Xk-fly/optical-flow-rangefinder-module/(list of files, drawings)

Other design files:
光流模块原理图和PCB/光流原理图与PCB整体.epro
