Xk-fly/optical-flow-rangefinder-module/Core/Src/main.c

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
/* Includes ------------------------------------------------------------------*/
#include "main.h"

/* USER CODE BEGIN Includes */
#include "PMW3901MB/pmw_3901.h"
#include "VL53L1X/vl53l1x.h"
#include "VL53L1X/vl53_ground_bootstrap.h"
#include "Adapter/massage_adapter.h"

/* USER CODE END Includes */

/* USER CODE BEGIN PD */
#define PMW_READ_DELAY_MS               1U
#define PMW_INIT_RETRY_INTERVAL_MS      1000U
#define PMW_SCALE_PER_MILLE             3000U
#define FLOW_PERIOD_MS                  20U
#define DISTANCE_PERIOD_MS              100U
#define HEARTBEAT_PERIOD_MS             1000U
#define PMW3901_ENABLE_PERIODIC_DIAGNOSTICS 0U
#if PMW3901_ENABLE_PERIODIC_DIAGNOSTICS
#define PMW_DIAG_PERIOD_MS              1000U
#endif

#if PMW3901_ACQUISITION_MODE == PMW3901_ACQ_DIRECT
#define PMW_MODE_STATUS_TEXT             "PMW mode direct"
#else
#define PMW_MODE_STATUS_TEXT             "PMW mode burst"
#endif

/* USER CODE END PD */

I2C_HandleTypeDef hi2c2;

SPI_HandleTypeDef hspi1;

TIM_HandleTypeDef htim14;

UART_HandleTypeDef huart2;

void SystemClock_Config(void);
static void MX_GPIO_Init(void);
static void MX_SPI1_Init(void);
static void MX_USART2_UART_Init(void);
static void MX_TIM14_Init(void);
static void MX_I2C2_Init(void);
/* USER CODE BEGIN PFP */
static void PMW_SendInitFailed(uint8_t err);
#if PMW3901_ENABLE_PERIODIC_DIAGNOSTICS
static void PMW_SendRawDiagnostics(void);
static void PMW_SendDirectDiagnostics(const PMW3901_Diagnostics *diagnostics);
static void PMW_SendDirectStatistics(const PMW3901_Diagnostics *diagnostics);
static void PMW_SendBurstStatistics(const PMW3901_Diagnostics *diagnostics);
#endif
static void PMW_SendConfigDiagnostics(void);
static uint8_t PMW_AppendChar(char *message, uint8_t index, char value);
static uint8_t PMW_AppendText(char *message, uint8_t index, const char *text);
static uint8_t PMW_AppendHex8(char *message, uint8_t index, uint8_t value);
#if PMW3901_ENABLE_PERIODIC_DIAGNOSTICS
static uint8_t PMW_AppendHex16(char *message, uint8_t index, uint16_t value);
#endif
static uint8_t PMW_AppendUnsigned(char *message, uint8_t index, uint32_t value);
#if PMW3901_ENABLE_PERIODIC_DIAGNOSTICS
static uint8_t PMW_AppendSigned(char *message, uint8_t index, int16_t value);
#endif

/* USER CODE END PFP */

/* USER CODE BEGIN 0 */
static void PMW_SendInitFailed(uint8_t err)
{
	char msg[] = "PMW init failed err=000";
	uint8_t index = 20U;

	if (err >= 100U) {
		msg[index++] = (char)('0' + (err / 100U));
		msg[index++] = (char)('0' + ((err / 10U) % 10U));
		msg[index++] = (char)('0' + (err % 10U));
		msg[index] = '\0';
	} else if (err >= 10U) {
		msg[index++] = (char)('0' + (err / 10U));
		msg[index++] = (char)('0' + (err % 10U));
		msg[index] = '\0';
	} else {
		msg[index++] = (char)('0' + err);
		msg[index] = '\0';
	}

	send_status_text(&huart2, MAV_SEVERITY_WARNING, msg);
}

static uint8_t PMW_AppendChar(char *message, uint8_t index, char value)
{
	if (index < 49U) {
		message[index++] = value;
	}
	message[index] = '\0';
	return index;
}

static uint8_t PMW_AppendText(char *message, uint8_t index, const char *text)
{
	while ((*text != '\0') && (index < 49U)) {
		message[index++] = *text++;
	}
	message[index] = '\0';
	return index;
}

static uint8_t PMW_AppendHex8(char *message, uint8_t index, uint8_t value)
{
	static const char hex[] = "0123456789ABCDEF";
	index = PMW_AppendChar(message, index, hex[(value >> 4) & 0x0FU]);
	return PMW_AppendChar(message, index, hex[value & 0x0FU]);
}

#if PMW3901_ENABLE_PERIODIC_DIAGNOSTICS
static uint8_t PMW_AppendHex16(char *message, uint8_t index, uint16_t value)
{
	index = PMW_AppendHex8(message, index, (uint8_t)(value >> 8));
	return PMW_AppendHex8(message, index, (uint8_t)value);
}
#endif

static uint8_t PMW_AppendUnsigned(char *message, uint8_t index, uint32_t value)
{
	char digits[3];
	uint8_t count = 0U;

	if (value > 999U) {
		value = 999U;
	}
	do {
		digits[count++] = (char)('0' + (value % 10U));
		value /= 10U;
	} while ((value != 0U) && (count < sizeof(digits)));

	while (count > 0U) {
		index = PMW_AppendChar(message, index, digits[--count]);
	}
	return index;
}

#if PMW3901_ENABLE_PERIODIC_DIAGNOSTICS
static uint8_t PMW_AppendSigned(char *message, uint8_t index, int16_t value)
{
	int32_t signed_value = value;
	uint32_t magnitude;
	char digits[5];
	uint8_t count = 0U;

	if (signed_value < 0) {
		index = PMW_AppendChar(message, index, '-');
		magnitude = (uint32_t)(-signed_value);
	} else {
		magnitude = (uint32_t)signed_value;
	}

	do {
		digits[count++] = (char)('0' + (magnitude % 10U));
		magnitude /= 10U;
	} while ((magnitude != 0U) && (count < sizeof(digits)));

	while (count > 0U) {
		index = PMW_AppendChar(message, index, digits[--count]);
	}
	return index;
}
#endif

#if PMW3901_ENABLE_PERIODIC_DIAGNOSTICS
static void PMW_SendRawDiagnostics(void)
{
	PMW3901_Diagnostics diagnostics;
	char message[50] = {0};
	uint8_t index = 0U;

	PMW3901_GetDiagnostics(&diagnostics);
	index = PMW_AppendText(message, index, "P S");
	index = PMW_AppendUnsigned(message, index, diagnostics.last_status);
	index = PMW_AppendText(message, index, " M");
	index = PMW_AppendHex8(message, index, diagnostics.last_raw.motion);
	index = PMW_AppendText(message, index, " O");
	index = PMW_AppendHex8(message, index, diagnostics.last_raw.observation);
	index = PMW_AppendText(message, index, " X");
	index = PMW_AppendSigned(message, index, diagnostics.last_raw.delta_x);
	index = PMW_AppendText(message, index, " Y");
	index = PMW_AppendSigned(message, index, diagnostics.last_raw.delta_y);
	index = PMW_AppendText(message, index, " Q");
	index = PMW_AppendUnsigned(message, index, diagnostics.last_raw.squal);
	index = PMW_AppendText(message, index, " H");
	index = PMW_AppendHex16(message, index, diagnostics.last_raw.shutter);
	index = PMW_AppendText(message, index, " E");
	index = PMW_AppendUnsigned(message, index, diagnostics.spi_error_count);
	index = PMW_AppendText(message, index, " R");
	(void)PMW_AppendUnsigned(message, index, diagnostics.reject_count);
	send_status_text(&huart2, MAV_SEVERITY_DEBUG, message);
	PMW_SendDirectDiagnostics(&diagnostics);
	PMW_SendDirectStatistics(&diagnostics);
	PMW_SendBurstStatistics(&diagnostics);
}

static void PMW_SendDirectDiagnostics(const PMW3901_Diagnostics *diagnostics)
{
	char message[50] = {0};
	uint8_t index = 0U;

	index = PMW_AppendText(message, index, "D S");
	index = PMW_AppendUnsigned(message, index, diagnostics->direct_status);
	index = PMW_AppendText(message, index, " M");
	index = PMW_AppendHex8(message, index, diagnostics->last_direct.motion);
	index = PMW_AppendText(message, index, " O");
	index = PMW_AppendHex8(message, index, diagnostics->last_direct.observation);
	index = PMW_AppendText(message, index, " X");
	index = PMW_AppendSigned(message, index, diagnostics->last_direct.delta_x);
	index = PMW_AppendText(message, index, " Y");
	index = PMW_AppendSigned(message, index, diagnostics->last_direct.delta_y);
	index = PMW_AppendText(message, index, " Q");
	index = PMW_AppendUnsigned(message, index, diagnostics->last_direct.squal);
	index = PMW_AppendText(message, index, " H");
	index = PMW_AppendHex16(message, index, diagnostics->last_direct.shutter);
	index = PMW_AppendText(message, index, " E");
	(void)PMW_AppendUnsigned(message, index, diagnostics->spi_error_count);
	send_status_text(&huart2, MAV_SEVERITY_DEBUG, message);
}

static void PMW_SendDirectStatistics(const PMW3901_Diagnostics *diagnostics)
{
	char message[50] = {0};
	uint8_t index = 0U;

	index = PMW_AppendText(message, index, "T C");
	index = PMW_AppendUnsigned(message, index, diagnostics->direct_sample_count);
	index = PMW_AppendText(message, index, " V");
	index = PMW_AppendUnsigned(message, index, diagnostics->direct_motion_count);
	index = PMW_AppendText(message, index, " Q");
	(void)PMW_AppendUnsigned(message, index, diagnostics->direct_squal_nonzero_count);
	send_status_text(&huart2, MAV_SEVERITY_DEBUG, message);
}

static void PMW_SendBurstStatistics(const PMW3901_Diagnostics *diagnostics)
{
	char message[50] = {0};
	uint8_t index = 0U;

	index = PMW_AppendText(message, index, "R U");
	index = PMW_AppendUnsigned(message, index, diagnostics->last_raw.raw_sum);
	index = PMW_AppendText(message, index, " A");
	index = PMW_AppendUnsigned(message, index, diagnostics->last_raw.raw_max);
	index = PMW_AppendText(message, index, " I");
	index = PMW_AppendUnsigned(message, index, diagnostics->last_raw.raw_min);
	index = PMW_AppendText(message, index, " C");
	index = PMW_AppendUnsigned(message, index, diagnostics->sample_count);
	index = PMW_AppendText(message, index, " V");
	index = PMW_AppendUnsigned(message, index, diagnostics->motion_count);
	index = PMW_AppendText(message, index, " Q");
	(void)PMW_AppendUnsigned(message, index, diagnostics->squal_nonzero_count);
	send_status_text(&huart2, MAV_SEVERITY_DEBUG, message);
}
#endif

static void PMW_SendConfigDiagnostics(void)
{
	PMW3901_Diagnostics diagnostics;
	char message[50] = {0};
	uint8_t index = 0U;

	PMW3901_GetDiagnostics(&diagnostics);
	index = PMW_AppendText(message, index, "C S");
	index = PMW_AppendUnsigned(message, index, diagnostics.config_status);
	index = PMW_AppendText(message, index, " D");
	index = PMW_AppendHex8(message, index, diagnostics.config_bank0_4d);
	index = PMW_AppendText(message, index, " A");
	index = PMW_AppendHex8(message, index, diagnostics.config_bank14_65);
	index = PMW_AppendText(message, index, " F");
	index = PMW_AppendHex8(message, index, diagnostics.config_bank15_48);
	index = PMW_AppendText(message, index, " N");
	(void)PMW_AppendUnsigned(message, index, diagnostics.config_mismatch_count);
	send_status_text(&huart2, MAV_SEVERITY_INFO, message);
}

/* USER CODE END 0 */

/**
  * @brief  The application entry point.
  * @retval int
  */
int main(void)
{

  /* MCU Configuration--------------------------------------------------------*/

  /* Reset of all peripherals, Initializes the Flash interface and the Systick. */
  HAL_Init();

  /* Configure the system clock */
  SystemClock_Config();

  /* Initialize all configured peripherals */
  MX_GPIO_Init();
  MX_SPI1_Init();
  MX_USART2_UART_Init();
	  MX_TIM14_Init();
	  MX_I2C2_Init();
	  /* USER CODE BEGIN 2 */
	  HAL_GPIO_WritePin(GPIOA, GPIO_PIN_4, GPIO_PIN_SET);

	  uint8_t pmw_err = PMW3901_init(hspi1, PMW_READ_DELAY_MS);
	  uint8_t pmw_ok = (pmw_err == 0U);
	  uint32_t pmw_last_retry_ms = HAL_GetTick();

	  if (pmw_ok) {
		  send_status_text(&huart2, MAV_SEVERITY_INFO, "PMW init ok");
		  send_status_text(&huart2, MAV_SEVERITY_INFO, PMW_MODE_STATUS_TEXT);
		  PMW_SendConfigDiagnostics();
	  } else {
		  PMW_SendInitFailed(pmw_err);
	  }
	  uint8_t vl53_ok = vl53_Init();
	  VL53GroundBootstrap range_bootstrap;
	  VL53GroundBootstrap_Reset(&range_bootstrap);
	  VL53RangeMode announced_range_mode = VL53_RANGE_BOOTSTRAP;
	  uint8_t announced_range_mode_valid = 0U;
	  send_status_text(&huart2, vl53_ok ? MAV_SEVERITY_INFO : MAV_SEVERITY_WARNING,
	                   vl53_ok ? "VL53 init ok" : "VL53 init failed");
	  send_heart_beat(&huart2);
  /* USER CODE END 2 */
  /* Infinite loop */
  /* USER CODE BEGIN WHILE */
  uint32_t scheduler_start_ms = HAL_GetTick();
  uint32_t last_flow_ms = scheduler_start_ms;
  uint32_t last_distance_ms = scheduler_start_ms;
  uint32_t last_heartbeat_ms = scheduler_start_ms;
#if PMW3901_ENABLE_PERIODIC_DIAGNOSTICS
  uint32_t last_diag_ms = scheduler_start_ms;
#endif
  uint16_t distance = 0U;
  uint8_t has_distance = 0U;
  uint32_t last_distance_update_ms = 0U;

  while (1) {
	  uint32_t now = HAL_GetTick();

	  if ((!pmw_ok) && (now - pmw_last_retry_ms >= PMW_INIT_RETRY_INTERVAL_MS)) {
		  pmw_last_retry_ms = now;
		  pmw_err = PMW3901_init(hspi1, PMW_READ_DELAY_MS);
		  pmw_ok = (pmw_err == 0U);
		  if (pmw_ok) {
			  send_status_text(&huart2, MAV_SEVERITY_INFO, "PMW init ok");
			  send_status_text(&huart2, MAV_SEVERITY_INFO, PMW_MODE_STATUS_TEXT);
			  PMW_SendConfigDiagnostics();
		  } else {
			  PMW_SendInitFailed(pmw_err);
		  }
	  }

#if PMW3901_ENABLE_PERIODIC_DIAGNOSTICS
	  if (now - last_diag_ms >= PMW_DIAG_PERIOD_MS) {
		  last_diag_ms = now;
		  PMW_SendRawDiagnostics();
	  }
#endif

	  if (now - last_flow_ms >= FLOW_PERIOD_MS) {
		  int x = 0;
		  int y = 0;
		  uint8_t quality = 0U;

		  last_flow_ms = now;
		  if (pmw_ok) {
			  pollingMotion(&x, &y, &quality, PMW_SCALE_PER_MILLE);
		  }
		  uint8_t distance_fresh = (has_distance != 0U) &&
		                           ((now - last_distance_update_ms) <= VL53_DISTANCE_FRESH_TIMEOUT_MS);
		  send_optical_flow(&huart2, x, y, quality, distance, distance_fresh);
	  }

	  if (now - last_distance_ms >= DISTANCE_PERIOD_MS) {
		  uint16_t new_distance = 0U;
		  uint16_t published_distance = 0U;
		  uint8_t using_bootstrap = 0U;
		  last_distance_ms = now;

		  if (vl53_ok) {
			  VL53ReadResult read_result = vl53_GetDistance(&new_distance);

			  if (VL53GroundBootstrap_Update(&range_bootstrap,
			                                 read_result,
			                                 new_distance,
			                                 &published_distance,
			                                 &using_bootstrap) != 0U) {
				  VL53RangeMode published_mode =
				      (using_bootstrap != 0U) ? VL53_RANGE_BOOTSTRAP : VL53_RANGE_REAL_FLIGHT;

				  distance = published_distance;
				  has_distance = 1U;
				  last_distance_update_ms = HAL_GetTick();
				  send_distance_sensor(&huart2, distance);

				  if ((announced_range_mode_valid == 0U) ||
				      (published_mode != announced_range_mode)) {
					  announced_range_mode = published_mode;
					  announced_range_mode_valid = 1U;
					  send_status_text(&huart2,
					                   MAV_SEVERITY_INFO,
					                   (published_mode == VL53_RANGE_BOOTSTRAP) ?
					                       "VL53 ground bootstrap V3 5cm" :
					                       "VL53 real range active");
				  }
			  }
		  }
	  }

	  if (now - last_heartbeat_ms >= HEARTBEAT_PERIOD_MS) {
		  last_heartbeat_ms = now;
		  send_heart_beat(&huart2);
	  }

    /* USER CODE END WHILE */

    /* USER CODE BEGIN 3 */
  }
  /* USER CODE END 3 */
}

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
