Xk-fly/optical-flow-rangefinder-module/STM32G030F6P6TR.ioc

Mcu.UserName=STM32G030F6Px
PA1.Signal=SPI1_SCK
PA13.Signal=SYS_SWDIO
PA14-BOOT0.Signal=SYS_SWCLK
PA2.Signal=USART2_TX
PA3.Signal=USART2_RX
PA4.Signal=GPIO_Output
PA6.Signal=SPI1_MISO
PA7.Signal=SPI1_MOSI
