Xk-fly/optical-flow-rangefinder-module/Core/Src/Adapter/massage_adapter.h

#include "main.h"
#include "mavlink/common/mavlink.h"
//#include "../mavlink/ardupilotmega/ardupilotmega.h"


void send_optical_flow(UART_HandleTypeDef *huart,int16_t flow_x, int16_t flow_y,
                       uint8_t quality, uint16_t distance_mm, uint8_t distance_valid);

void send_heart_beat(UART_HandleTypeDef *huart);

void send_distance_sensor(UART_HandleTypeDef *huart,uint16_t distance);

void send_status_text(UART_HandleTypeDef *huart, uint8_t severity, const char *text);
