Xk-fly/optical-flow-rangefinder-module/(commit log)

2026-09-04 chore: stage source import payload
2026-09-04 feat: import optical flow rangefinder module source
    [光流原理图与PCB整体.epro]
2026-09-18 fix: add lightweight median filter to VL53 distance
    [vl53l1x.c]
2026-09-18 fix: keep recent VL53 distance fresh for optical flow
    [main.c]
2026-09-18 fix: harden VL53 median filtering and freshness
    [main.c, test_vl53_median_filter.c, verify_production_firmware.py, vl53_median_filter.c, vl53_median_filter.h, vl53l1x.c, vl53l1x.h]
2026-09-23 feat: add VL53 ground bootstrap state machine
2026-09-23 test: cover VL53 ground bootstrap safety
2026-09-23 test: add VL53 ground bootstrap host runner
2026-09-23 feat: publish safe 5cm ground bootstrap range
2026-09-23 test: enforce ground bootstrap production contract
2026-09-23 docs: document safe VL53 ground bootstrap
2026-09-23 ci: build and validate ground bootstrap firmware
2026-09-23 fix: validate near-field bootstrap with VL53 range status
    [vl53l1x.c]
2026-09-23 feat: accept successful sub-5cm VL53 reads as ground near-field
2026-09-23 feat: define repeatable ground bootstrap v2 states
2026-09-23 feat: implement repeatable takeoff landing bootstrap cycle
2026-09-23 fix: clear landing arming when range climbs above 20cm
    [vl53_ground_bootstrap.c]
2026-09-23 test: cover repeated bootstrap v2 takeoff landing cycles
2026-09-23 feat: announce every bootstrap v2 ground flight transition
2026-09-23 test: enforce repeatable ground bootstrap v2 contract
2026-09-23 docs: describe repeatable ground bootstrap v2 cycle
2026-09-23 ci: package ground bootstrap v2 firmware and metadata
2026-09-23 fix: expire stale landing arm evidence in real flight
    [vl53_ground_bootstrap.c]
2026-09-30 refactor: define simpler VL53 ground bootstrap V3
2026-09-30 fix: recover bootstrap from near-ground VL53 NoData
    [vl53_ground_bootstrap.c]
2026-09-30 test: cover VL53 ground bootstrap V3 recovery
2026-09-30 chore: announce VL53 ground bootstrap V3
2026-09-30 docs: align VL53 driver comment with V3
2026-09-30 test: enforce VL53 ground bootstrap V3 contract
2026-09-30 ci: build and label VL53 ground bootstrap V3
